nikisalli/nik-lidar/README.md

# nik-lidar
a low cost 3d printed 3d lidar based on ydlidar-x4, esp32 and cheap parts!

- project status: complete, needs cleanup

# info
In this repo you can find all what's necessary to assemble your own 3d lidar able to make acceptable quality 360° 3d scans

feel free to contribute since I don't have time to clean up this project

# images and results
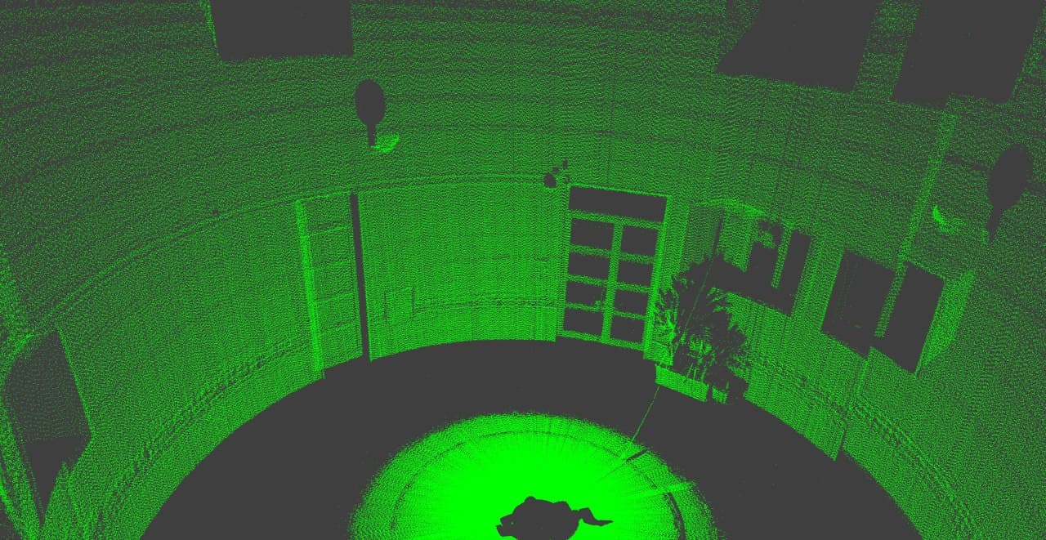
[picture p1: images/photo1.jpg]

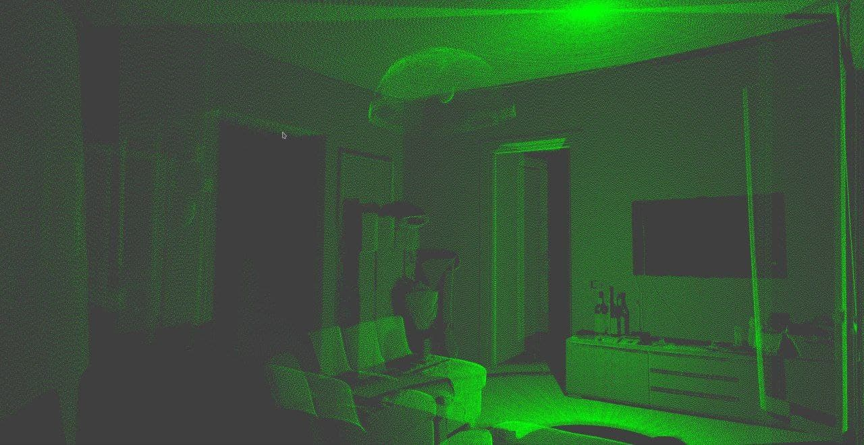
[picture p2: images/photo2.jpg]

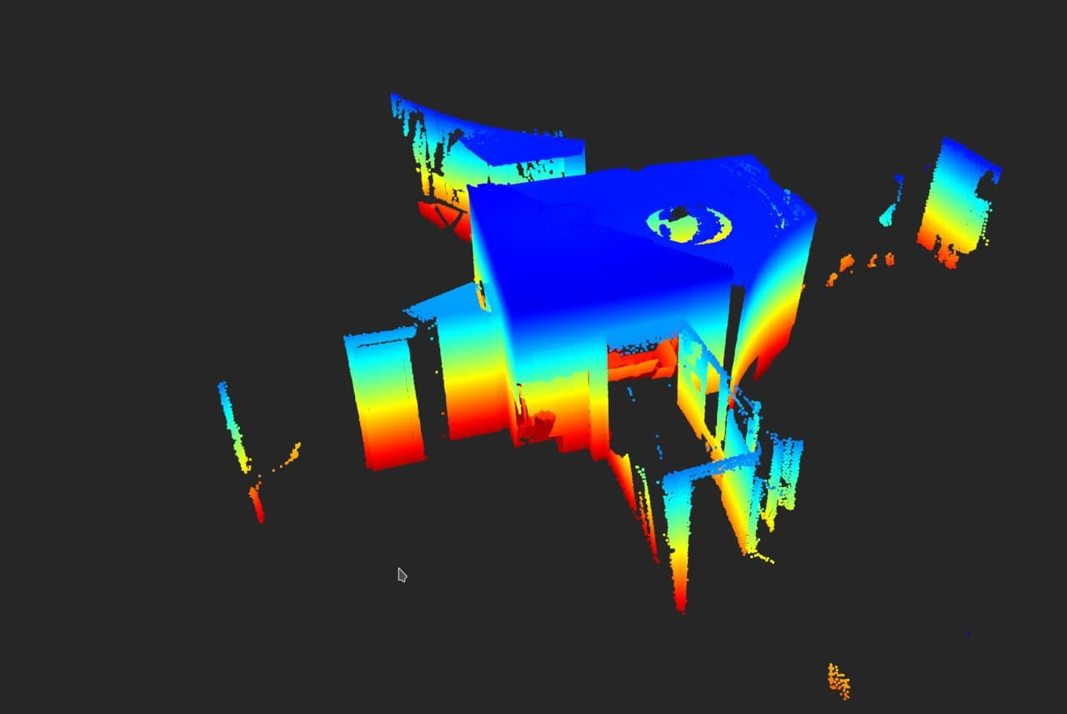
[picture p3: images/photo3.jpg]

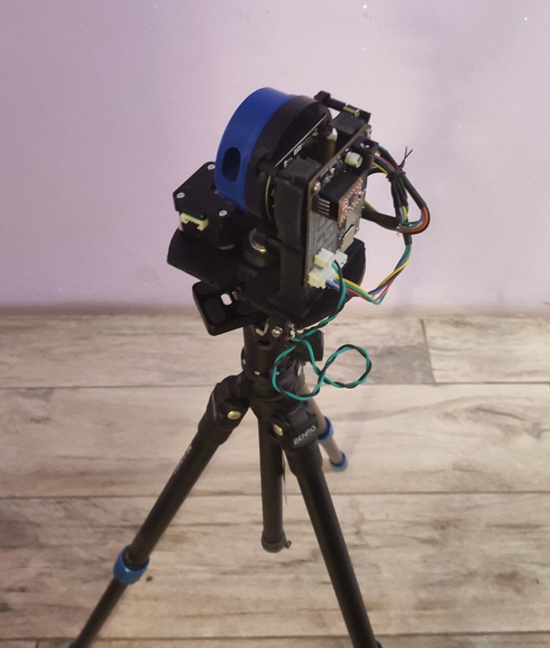
[picture p4: images/photo4.jpg]

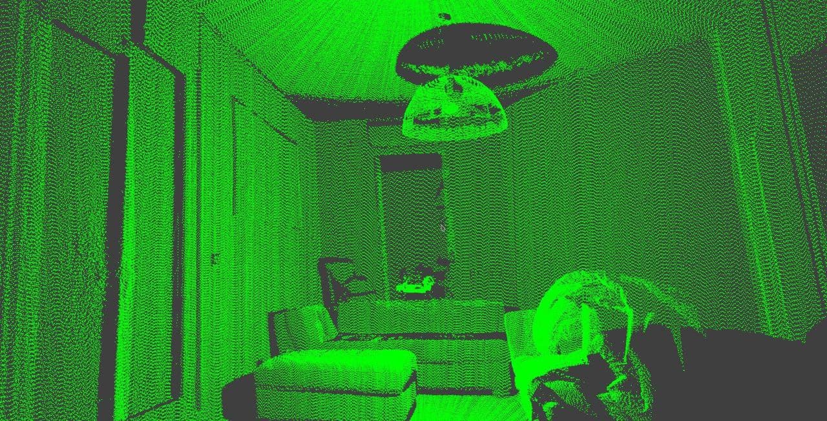
[picture p5: images/photo5.jpg]

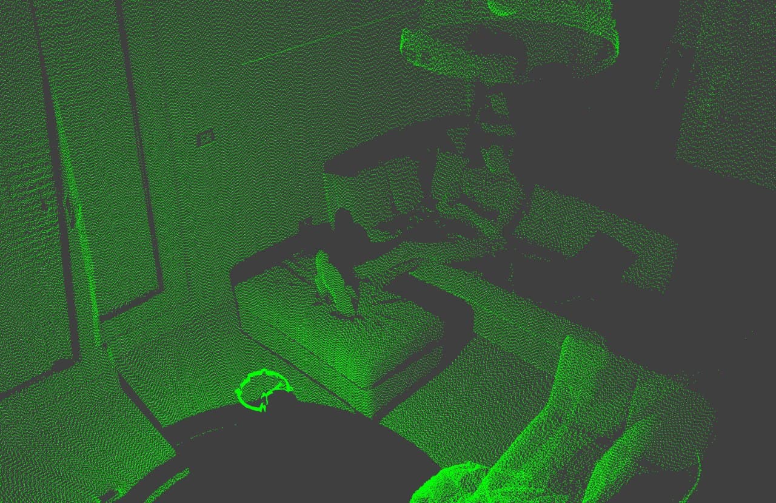
[picture p6: images/photo6.jpg]

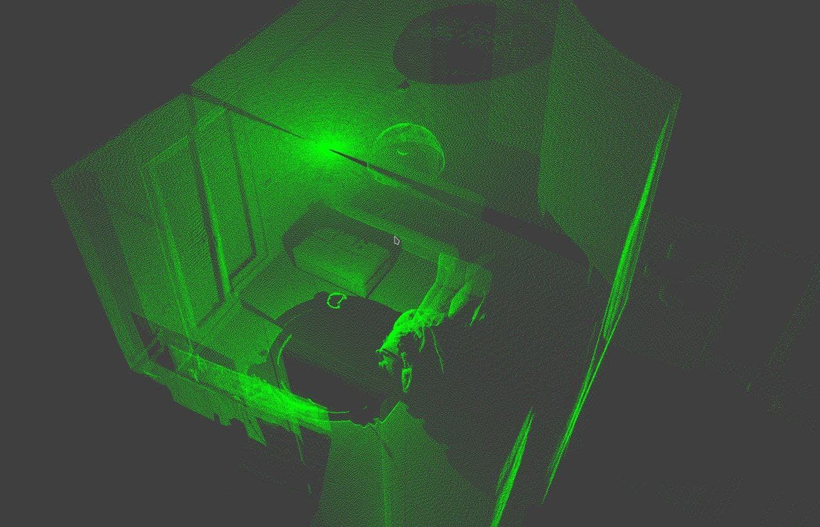
[picture p7: images/photo7.jpg]
