nikisalli/nik-lidar/hardware/3d_models/main_body_piece_x1.stl

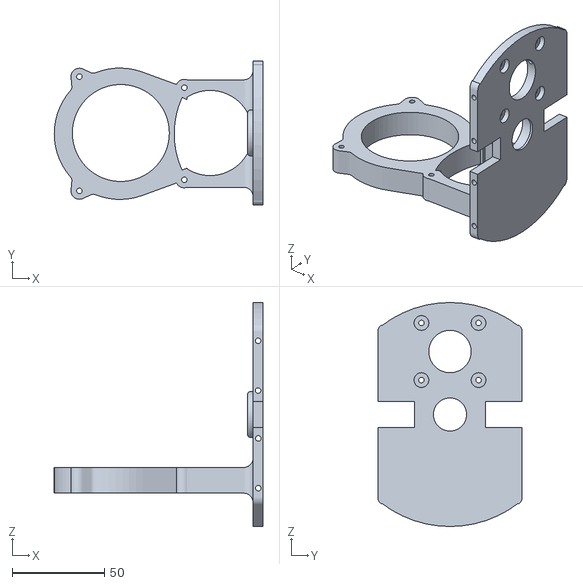
[picture p8: CAD file, 2020-07-16]
hardware/3d_models/main_body_piece_x1.stl
113.2 x 78.4 x 121.6
