nikisalli/nik-lidar/hardware/3d_models/base_timing_pulley_x1.stl

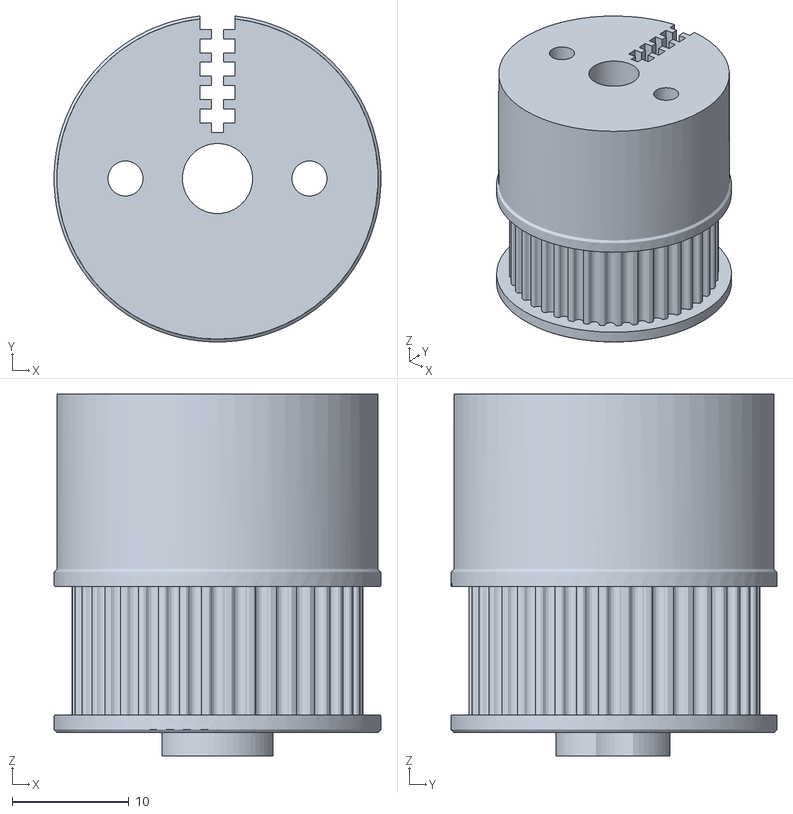
[picture p9: CAD file, 2020-07-16]
hardware/3d_models/base_timing_pulley_x1.stl
28.0 x 27.9 x 31.0
