nikisalli/nik-lidar/hardware/3d_models/cover_piexe_x2.stl

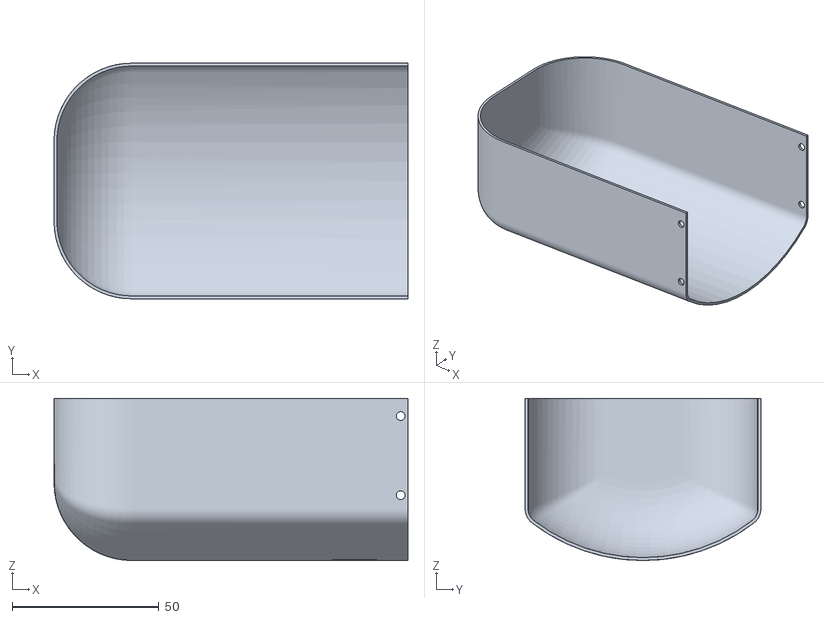
[picture p10: CAD file, 2020-07-16]
hardware/3d_models/cover_piexe_x2.stl
120.8 x 80.4 x 55.3
