nikisalli/nik-lidar/hardware/3d_models/endstop_x1.stl

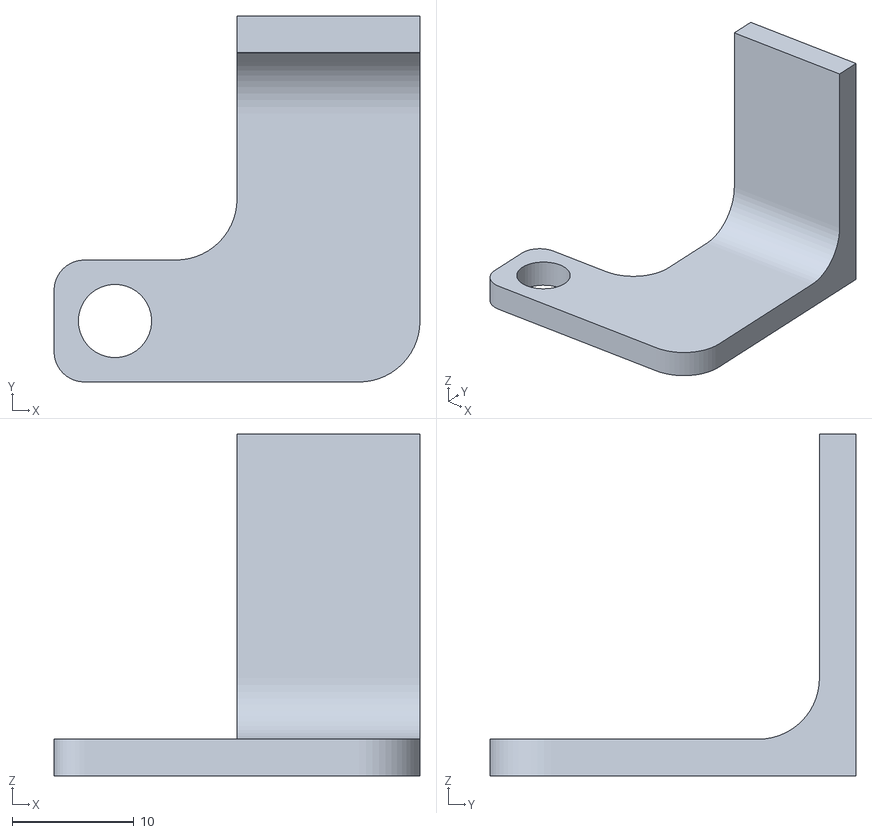
[picture p11: CAD file, 2020-07-16]
hardware/3d_models/endstop_x1.stl
30.0 x 30.0 x 28.0
