nikisalli/nik-lidar/hardware/3d_models/distancer_noprint.stl

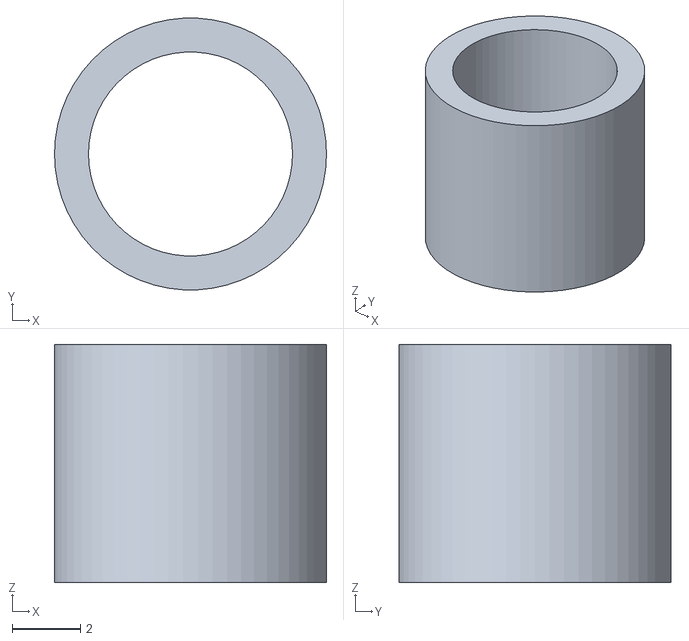
[picture p12: CAD file, 2020-07-16]
hardware/3d_models/distancer_noprint.stl
8.00 x 7.99 x 7.00
