nikisalli/nik-lidar/hardware/3d_models/motor_pulley_noprint.stl

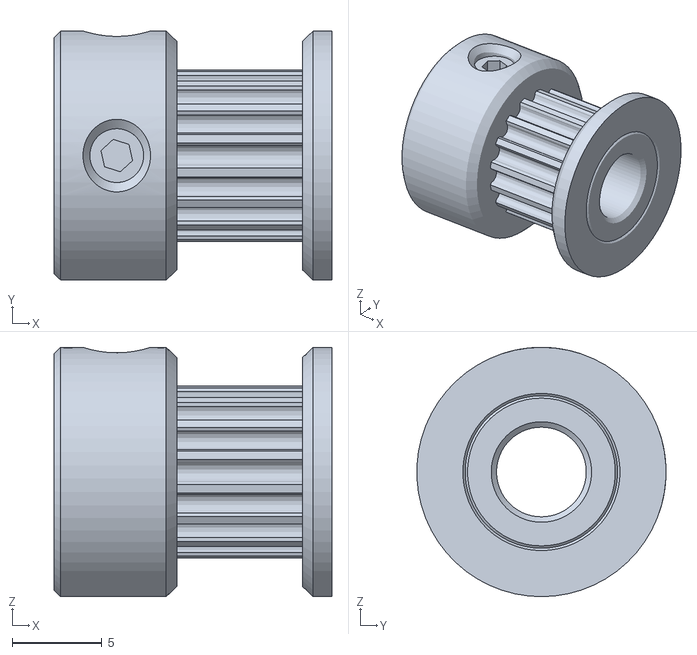
[picture p13: CAD file, 2020-07-16]
hardware/3d_models/motor_pulley_noprint.stl
15.5 x 13.9 x 13.9
