nikisalli/nik-lidar/hardware/3d_models/hexagonal_distancers_noprint.stl

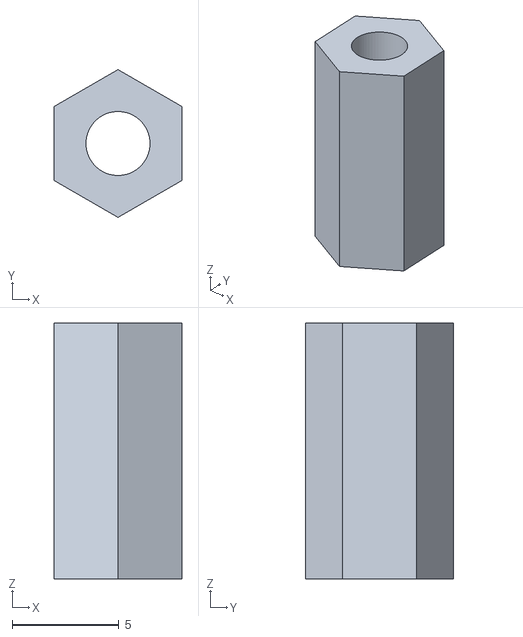
[picture p14: CAD file, 2020-07-16]
hardware/3d_models/hexagonal_distancers_noprint.stl
6.00 x 6.93 x 12.0
