nikisalli/nik-lidar/hardware/lidar_driver_board/esp32_stepper_driver.pdf

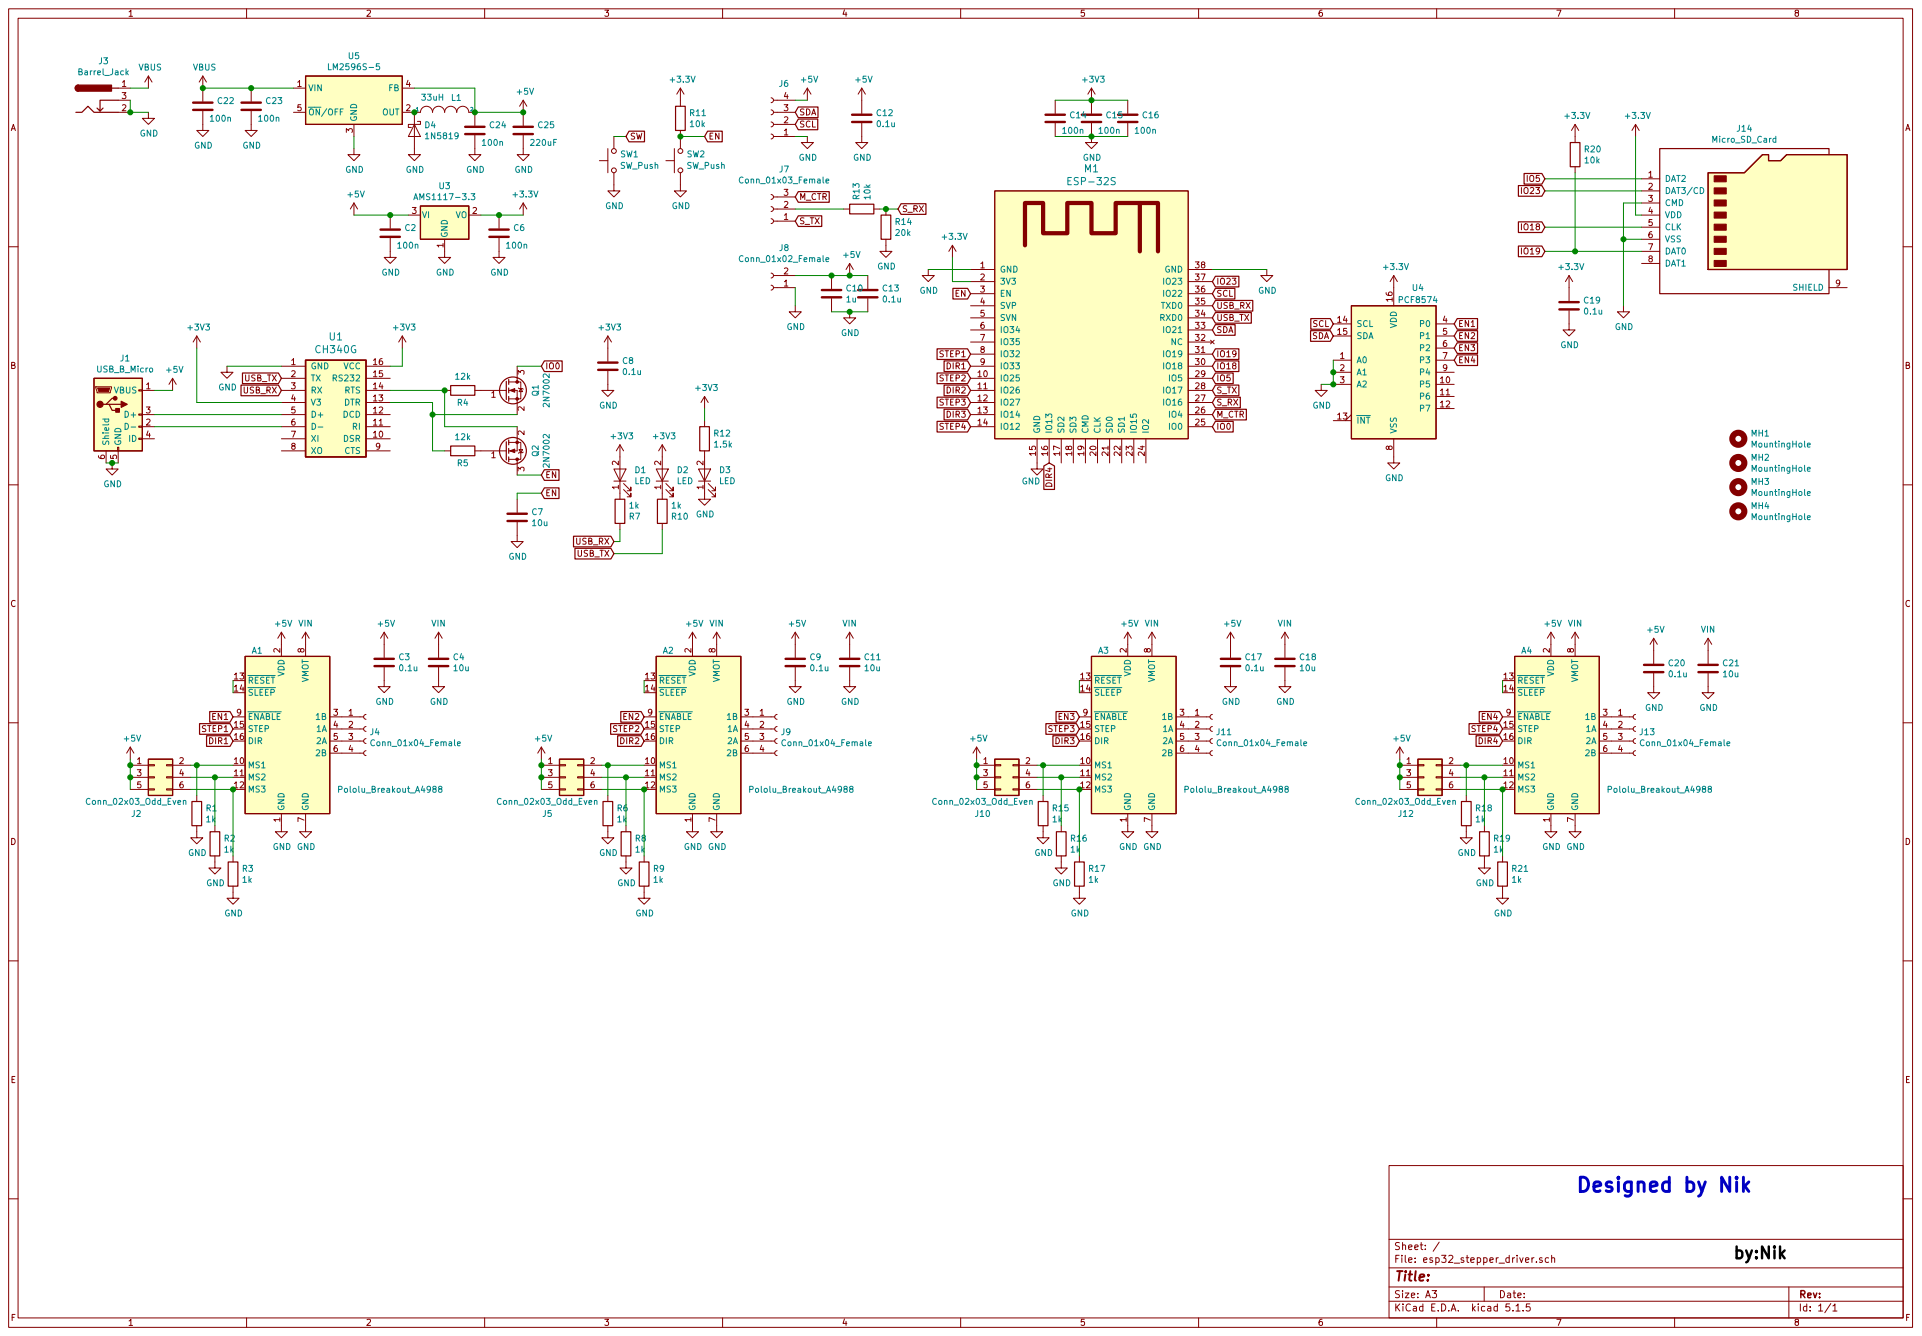
[picture p15: page 1]

8 ENABLE 9 MS1 10 MS2 11 MS3 12 RESET 13 SLEEP 14 STEP 15 DIR 16 A1 Pololu_Breakout_A4988 GND

8 ENABLE 9 MS1 10 MS2 11 MS3 12 RESET 13 SLEEP 14 STEP 15 DIR 16 A2 Pololu_Breakout_A4988 GND

8 ENABLE 9 MS1 10 MS2 11 MS3 12 RESET 13 SLEEP 14 STEP 15 DIR 16 A3 Pololu_Breakout_A4988 GND

8 ENABLE 9 MS1 10 MS2 11 MS3 12 RESET 13 SLEEP 14 STEP 15 DIR 16 A4 Pololu_Breakout_A4988
