nikisalli/nik-lidar/hardware/lidar_driver_board/esp32_stepper_driver.kicad_pcb

## KiCad design hardware/lidar_driver_board/esp32_stepper_driver.kicad_pcb (2021-03-23)

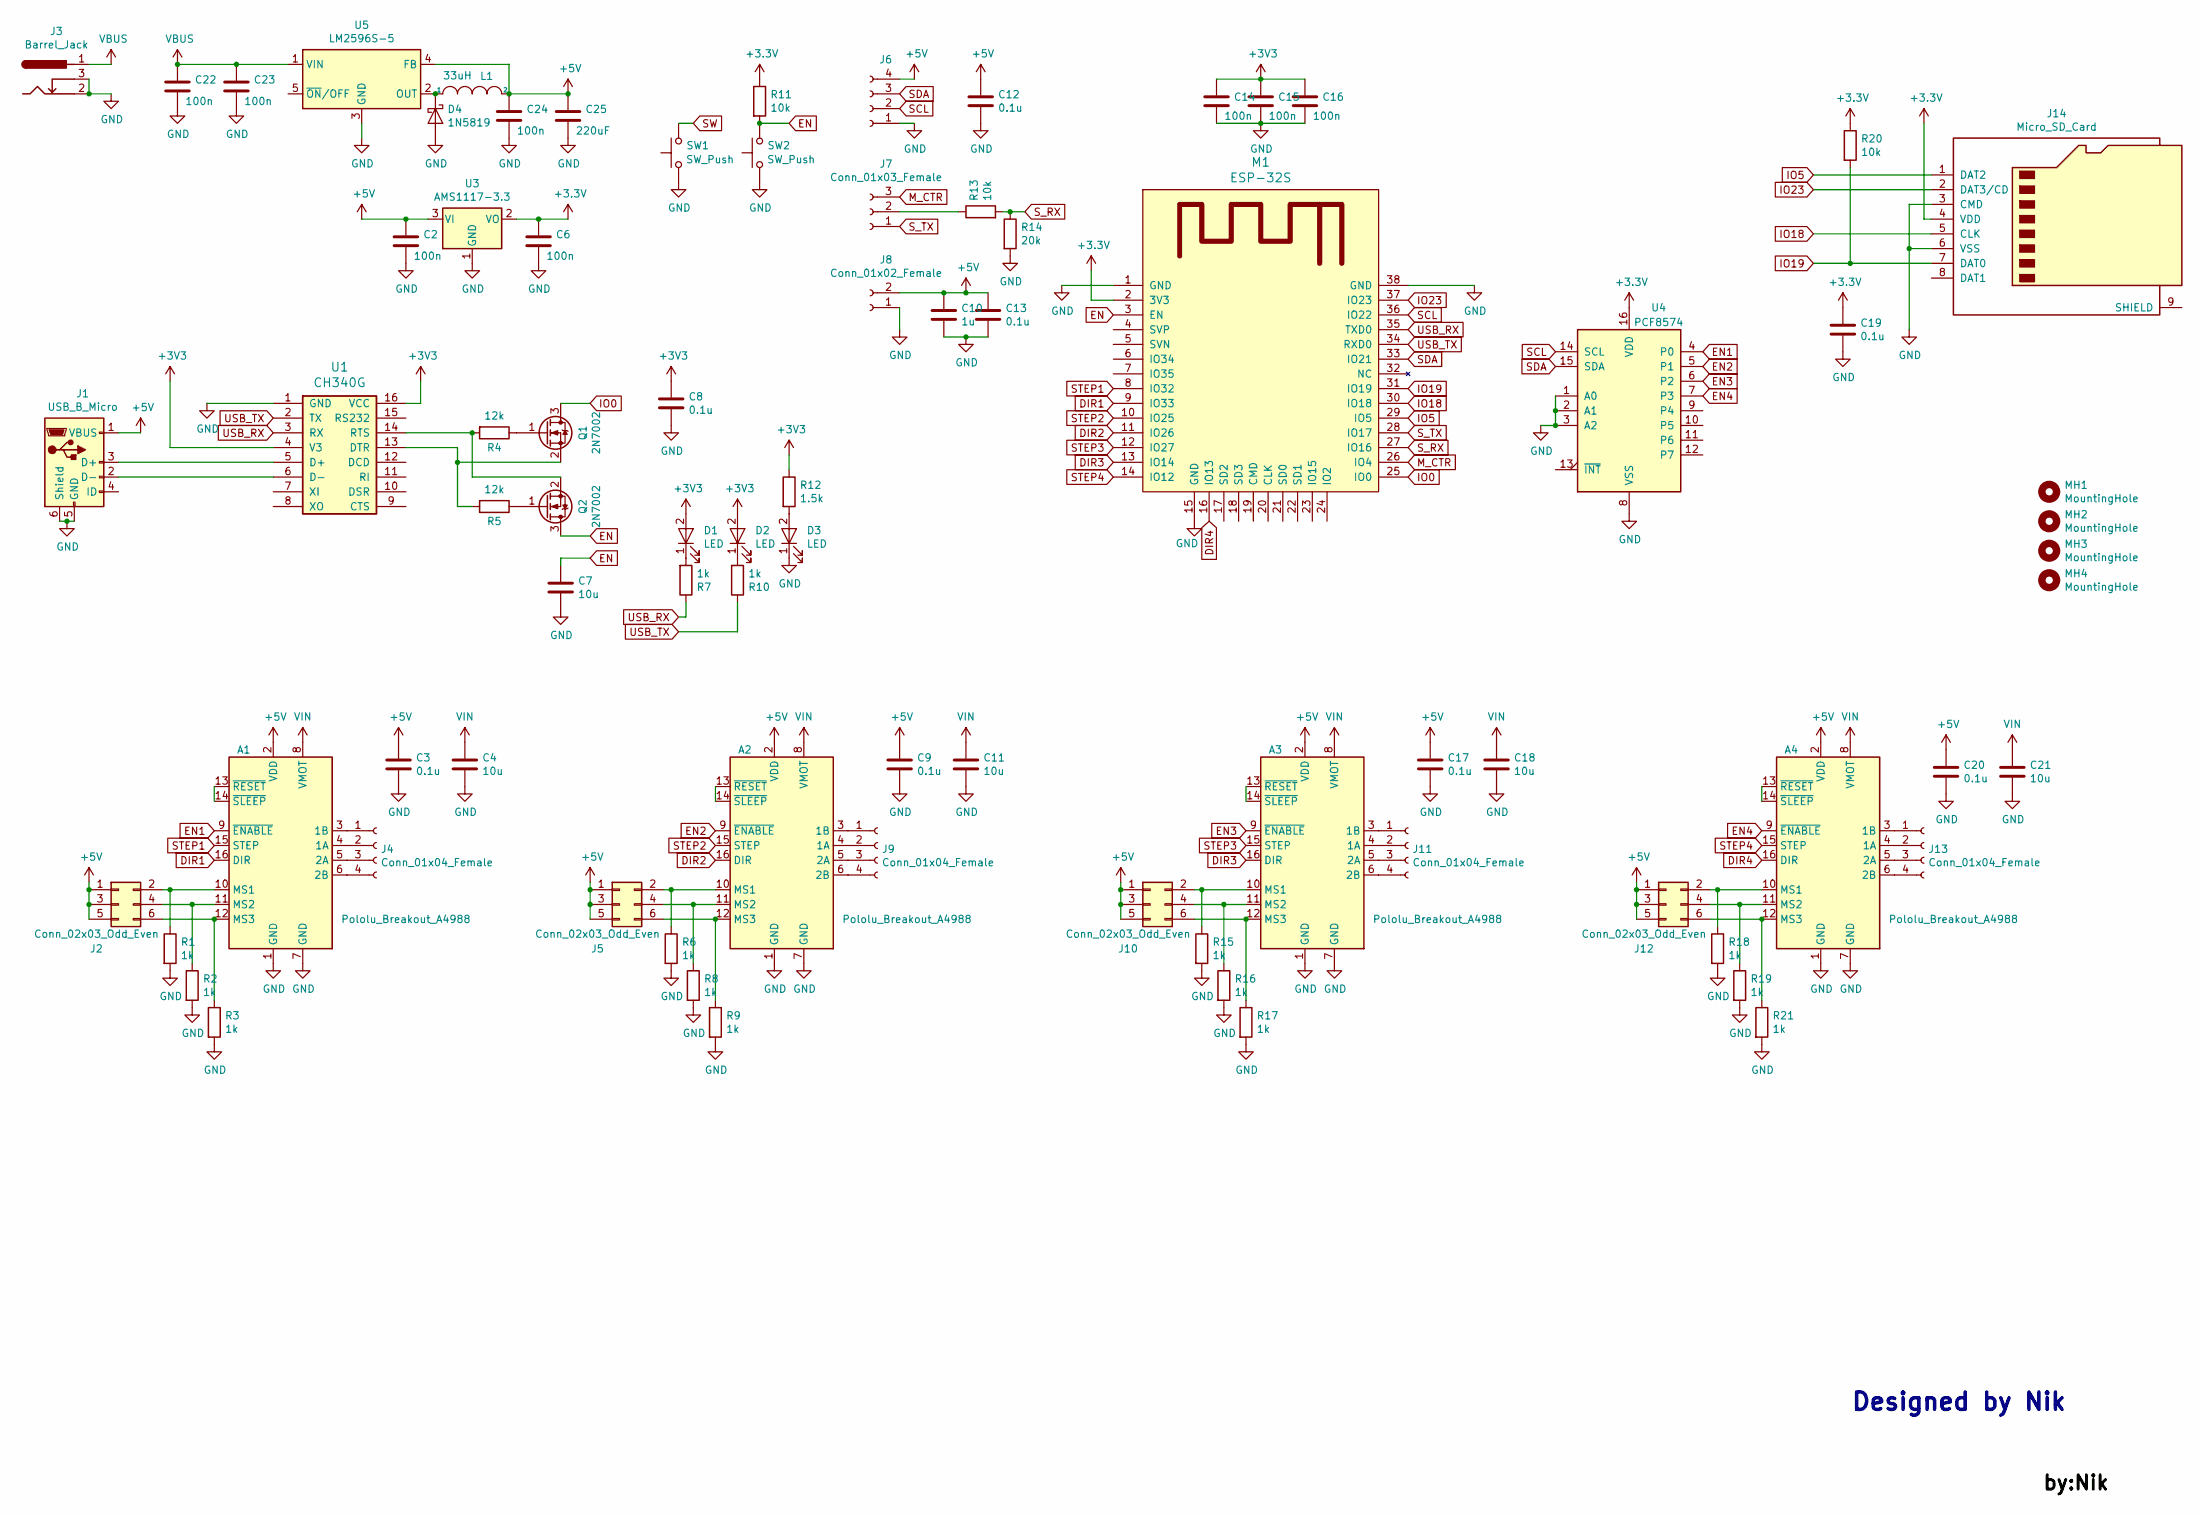
[picture p16: schematic esp32_stepper_driver.sch]

Parts:
A1, A2, A3, A4: Pololu_Breakout_A4988; a4988
C2, C6, C14, C15, C16, C22, C23, C24: 100n; C_0603_1608Metric
C3, C8, C9, C12, C13, C17, C19, C20: 0.1u; C_0603_1608Metric_Pad1.05x0.95mm_HandSolder
C4, C11, C18, C21: 10u; C_1206_3216Metric_Pad1.42x1.75mm_HandSolder
C7: 10u; C_1206_3216Metric
C10: 1u; C_0603_1608Metric_Pad1.05x0.95mm_HandSolder
C25: 220uF; C_Elec_6.3x7.7
D1, D2, D3: LED; LED_0603_1608Metric_Pad1.05x0.95mm_HandSolder
D4: 1N5819; D_SOD-123
J1: USB_B_Micro; USB_Micro-B_Molex_47346-0001
J2, J5, J10, J12: Conn_02x03_Odd_Even; PinHeader_2x03_P2.54mm_Vertical
J3: Barrel_Jack; BarrelJack_Horizontal
J4, J6, J9, J11, J13: Conn_01x04_Female; JST_XH_B4B-XH-A_1x04_P2.50mm_Vertical
J7: Conn_01x03_Female; JST_XH_B3B-XH-A_1x03_P2.50mm_Vertical
J8: Conn_01x02_Female; JST_XH_B2B-XH-A_1x02_P2.50mm_Vertical
J14: Micro_SD_Card; Conn_uSDcard
L1: 33uH; L_12x12mm_H8mm
M1: ESP-32S
MH1, MH2, MH3, MH4: MountingHole; MountingHole_3.2mm_M3_DIN965_Pad
Q1, Q2: 2N7002; SOT-23
R1, R2, R3, R6, R8, R9, R15, R16, R17, R18, R19, R21: 1k; R_0603_1608Metric_Pad1.05x0.95mm_HandSolder
R4, R5: 12k; R_0603_1608Metric
R7, R10: 1k; R_0603_1608Metric
R11, R13: 10k; R_0603_1608Metric
R12: 1.5k; R_0603_1608Metric
R14: 20k; R_0603_1608Metric
R20: 10k; R_0603_1608Metric_Pad1.05x0.95mm_HandSolder
SW1, SW2: SW_Push; SW_SPST_SKQG_WithoutStem
U1: CH340G; SOIC-16_3.9x9.9mm_P1.27mm
U3: AMS1117-3.3; SOT-223-3_TabPin2
U4: PCF8574; SOIC-16W_7.5x10.3mm_P1.27mm
U5: LM2596S-5; TO-263-5_TabPin3

Connections:
+5V: A1.2 (VDD), A2.2 (VDD), A3.2 (VDD), A4.2 (VDD), C2.1, C3.1, C9.1, C10.1, C12.1, C13.1, C17.1, C20.1, C24.1, C25.1, J1.1 (VBUS), J2.1, J2.3, J2.5, J5.1, J5.3, J5.5, J6.4, J8.2, J10.1, J10.3, J10.5, J12.1, J12.3, J12.5, L1.2, U3.3 (VI), U5.4 (FB)
DIR1: A1.16 (DIR), M1.9 (IO33)
DIR2: A2.16 (DIR), M1.11 (IO26)
DIR3: A3.16 (DIR), M1.13 (IO14)
DIR4: A4.16 (DIR), M1.16 (IO13)
EN: C7.1, M1.3 (EN), Q2.3 (D), R11.2, SW2.2
EN1: A1.9 (~ENABLE), U4.4 (P0)
EN2: A2.9 (~ENABLE), U4.5 (P1)
EN3: A3.9 (~ENABLE), U4.6 (P2)
EN4: A4.9 (~ENABLE), U4.7 (P3)
GND: A1.1 (GND), A1.7 (GND), A2.1 (GND), A2.7 (GND), A3.1 (GND), A3.7 (GND), A4.1 (GND), A4.7 (GND), C2.2, C3.2, C4.2, C6.2, C7.2, C8.2, C9.2, C10.2, C11.2, C12.2, C13.2, C14.2, C15.2, C16.2, C17.2, C18.2, C19.2, C20.2, C21.2, C22.2, C23.2, C24.2, C25.2, D3.1 (K), D4.2 (A), J1.5 (GND), J1.6 (Shield), J3.2, J3.3, J6.1, J8.1, J14.3 (CMD), J14.6 (VSS), M1.1 (GND), M1.15 (GND), M1.38 (GND), R1.2, R2.2, R3.2, R6.2, R8.2, R9.2, R14.2, R15.2, R16.2, R17.2, R18.2, R19.2, R21.2, SW1.1, SW2.1, U1.1 (GND), U3.1 (GND), U4.1 (A0), U4.2 (A1), U4.3 (A2), U4.8 (VSS), U5.3 (GND)
IO0: M1.25 (IO0), Q1.3 (D)
IO5: J14.1 (DAT2), M1.29 (IO5)
IO18: J14.5 (CLK), M1.30 (IO18)
IO19: J14.7 (DAT0), M1.31 (IO19), R20.2
IO23: J14.2 (DAT3/CD), M1.37 (IO23)
M_CTR: J7.3, M1.26 (IO4)
unnamed: A1.3 (1B), J4.1
unnamed: A1.4 (1A), J4.2
unnamed: A1.5 (2A), J4.3
unnamed: A1.6 (2B), J4.4
unnamed: A1.10 (MS1), J2.2, R1.1
unnamed: A1.11 (MS2), J2.4, R2.1
unnamed: A1.12 (MS3), J2.6, R3.1
unnamed: A1.13 (~RESET), A1.14 (~SLEEP)
unnamed: A2.3 (1B), J9.1
unnamed: A2.4 (1A), J9.2
unnamed: A2.5 (2A), J9.3
unnamed: A2.6 (2B), J9.4
unnamed: A2.10 (MS1), J5.2, R6.1
unnamed: A2.11 (MS2), J5.4, R8.1
unnamed: A2.12 (MS3), J5.6, R9.1
unnamed: A2.13 (~RESET), A2.14 (~SLEEP)
unnamed: A3.3 (1B), J11.1
unnamed: A3.4 (1A), J11.2
unnamed: A3.5 (2A), J11.3
unnamed: A3.6 (2B), J11.4
unnamed: A3.10 (MS1), J10.2, R15.1
unnamed: A3.11 (MS2), J10.4, R16.1
unnamed: A3.12 (MS3), J10.6, R17.1
unnamed: A3.13 (~RESET), A3.14 (~SLEEP)
unnamed: A4.3 (1B), J13.1
unnamed: A4.4 (1A), J13.2
unnamed: A4.5 (2A), J13.3
unnamed: A4.6 (2B), J13.4
unnamed: A4.10 (MS1), J12.2, R18.1
unnamed: A4.11 (MS2), J12.4, R19.1
unnamed: A4.12 (MS3), J12.6, R21.1
unnamed: A4.13 (~RESET), A4.14 (~SLEEP)
unnamed: D1.1 (K), R7.2
unnamed: D2.1 (K), R10.2
unnamed: D3.2 (A), R12.2
unnamed: D4.1 (K), L1.1, U5.2 (OUT)
unnamed: J1.2 (D-), U1.6 (D-)
unnamed: J1.3 (D+), U1.5 (D+)
unnamed: J7.2, R13.1
unnamed: Q1.1 (G), R4.1
unnamed: Q1.2 (S), R5.2, U1.13 (DTR)
unnamed: Q2.1 (G), R5.1
unnamed: Q2.2 (S), R4.2, U1.14 (RTS)
SCL: J6.2, M1.36 (IO22), U4.14 (SCL)
SDA: J6.3, M1.33 (IO21), U4.15 (SDA)
STEP1: A1.15 (STEP), M1.8 (IO32)
STEP2: A2.15 (STEP), M1.10 (IO25)
STEP3: A3.15 (STEP), M1.12 (IO27)
STEP4: A4.15 (STEP), M1.14 (IO12)
SW: SW1.2
S_RX: M1.27 (IO16), R13.2, R14.1
S_TX: J7.1, M1.28 (IO17)
USB_RX: M1.35 (TXD0), R7.1, U1.3 (RX)
USB_TX: M1.34 (RXD0), R10.1, U1.2 (TX)
VBUS: C22.1, C23.1, J3.1, U5.1 (VIN)
VIN: A1.8 (VMOT), A2.8 (VMOT), A3.8 (VMOT), A4.8 (VMOT), C4.1, C11.1, C18.1, C21.1

Notes on the sheet:
Designed by Nik

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
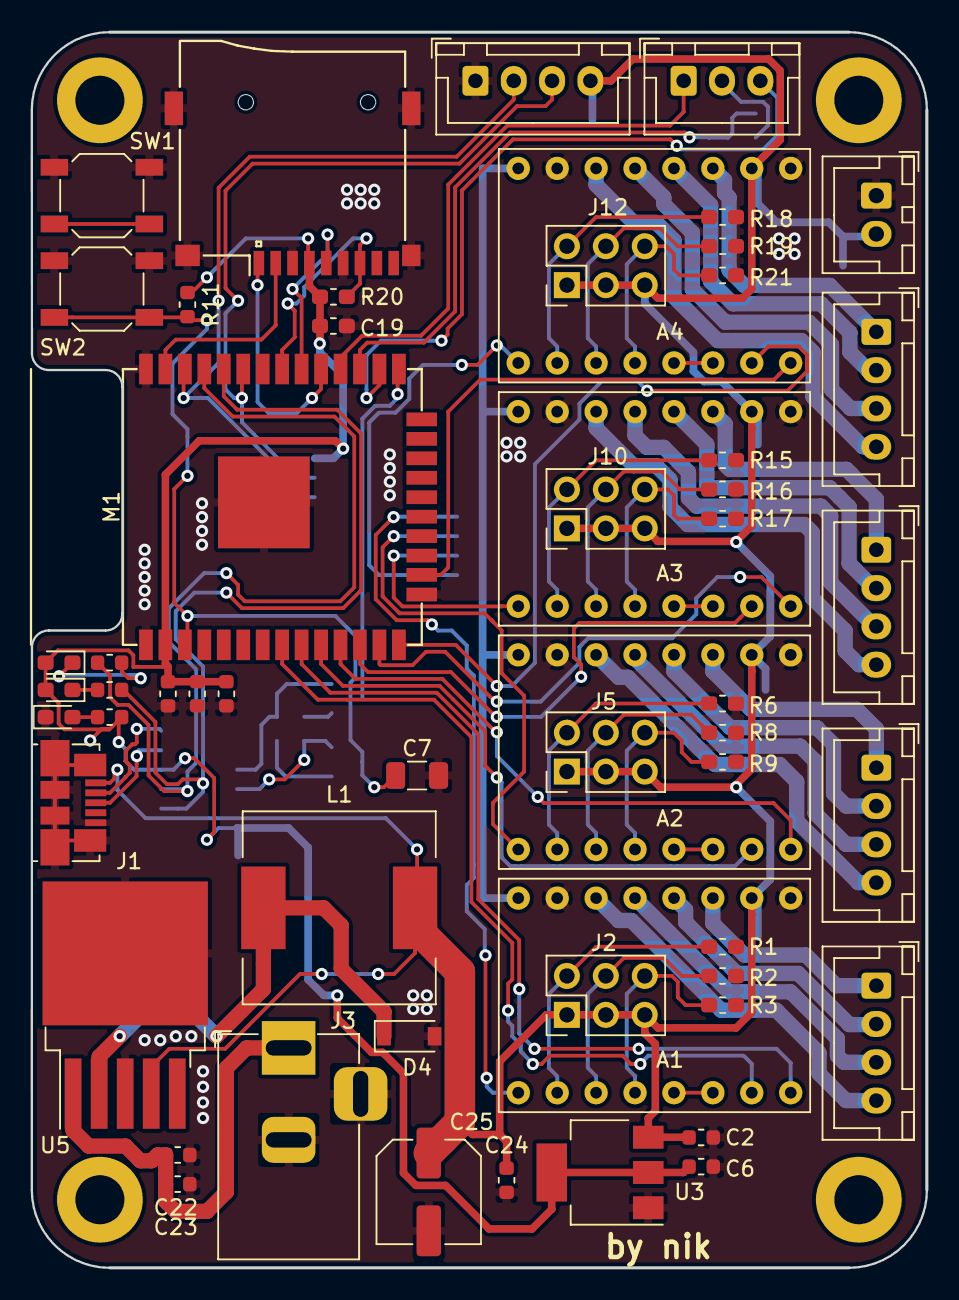
[picture p17: board esp32_stepper_driver.kicad_pcb from above]

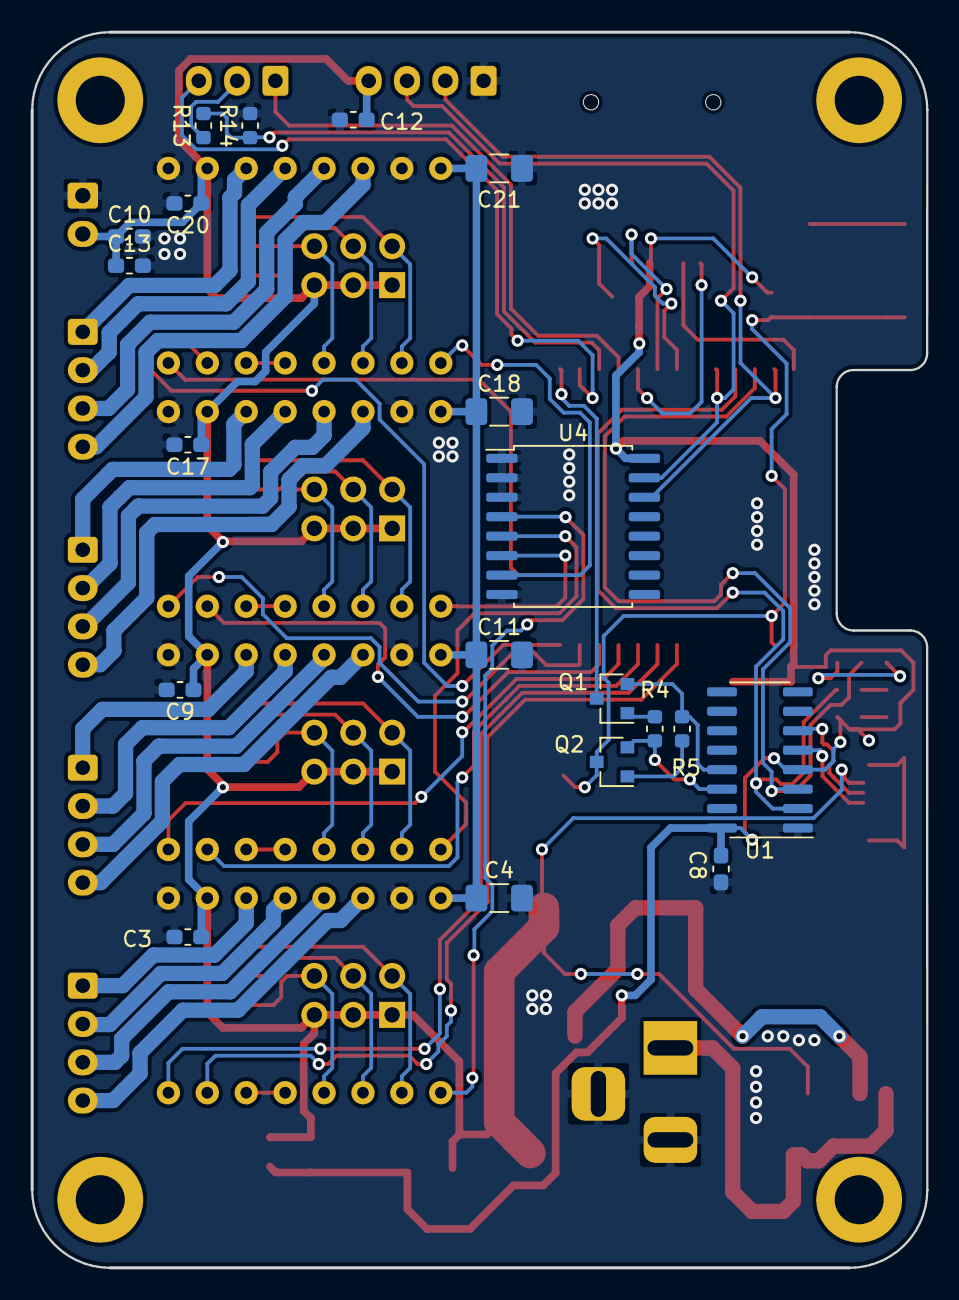
[picture p18: board esp32_stepper_driver.kicad_pcb from below]

Board: 2 copper layers, 58.4 x 80.6 mm, 80 parts (20 on the bottom side), 73 nets.
