nikisalli/nik-lidar/(commit log)

2020-05-03 added ota upload and basic motor setup
2020-07-16 added example config file, 3d files and fixed bugs
    [base_timing_pulley_x1.stl, cover_piexe_x2.stl, distancer_noprint.stl, endstop_x1.stl, hexagonal_distancers_noprint.stl, motor_pulley_noprint.stl]
2020-07-21 changed file names and added pcb and schematics
    [esp32_stepper_driver.kicad_pcb, esp32_stepper_driver.sch]
2021-03-23 hardware fixes
    [esp32_stepper_driver-B_Cu.gbr, esp32_stepper_driver-B_Mask.gbr, esp32_stepper_driver-B_Paste.gbr, esp32_stepper_driver-B_SilkS.gbr, esp32_stepper_driver-Edge_Cuts.gbr, esp32_stepper_driver-F_Cu.gbr, esp32_stepper_driver-F_Mask.gbr, esp32_stepper_driver-F_Paste.gbr]
2021-03-23 fixed file name
    [main_body_piece_x1.stl]
